joshuawe/Micromouse/README.md

# Micromouse
Micromouse TUM (Wintersemesester 2021/2022)

This is the repository of the Micromouse team of:
+ Marius
+ Michelle
+ Miriam
+ Joshua
