joshuawe/Micromouse/documents/2x2maze2.jpg

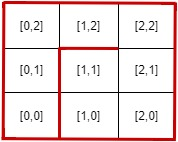
documents/2x2maze2.jpg
