joshuawe/Micromouse/documents/2x2maze.jpg

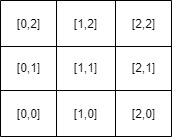
documents/2x2maze.jpg
