joshuawe/Micromouse/documents/code-structure.png

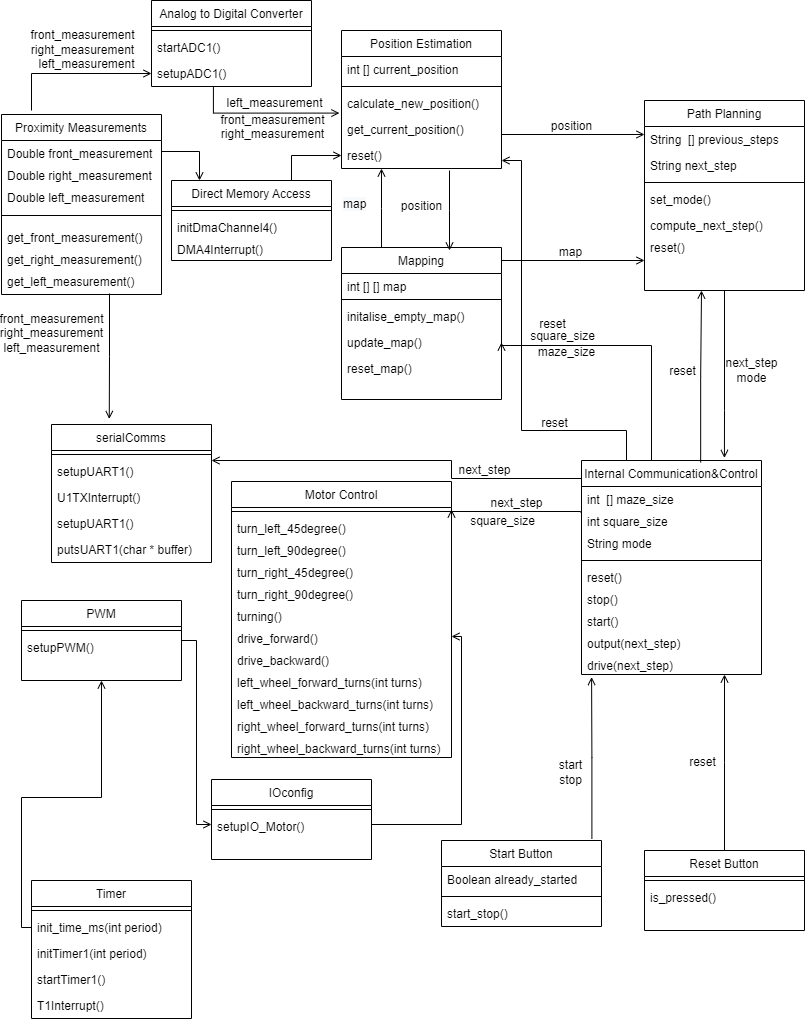
documents/code-structure.png
