joshuawe/Micromouse/documents/graphexample2.jpg

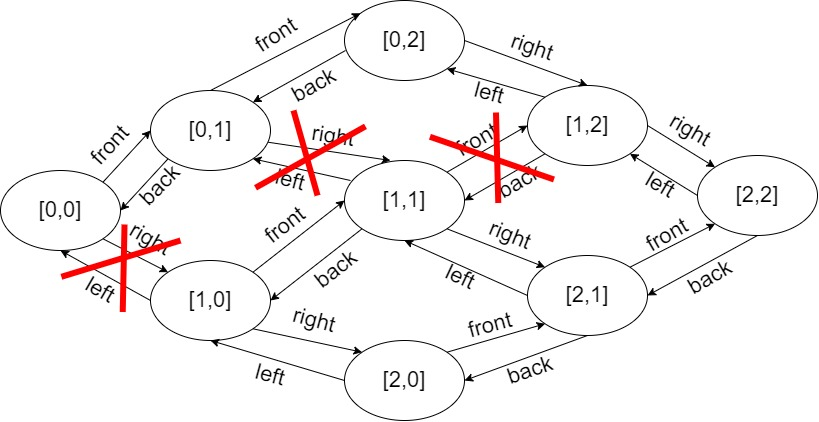
documents/graphexample2.jpg
