joshuawe/Micromouse/documents/Maze2.png

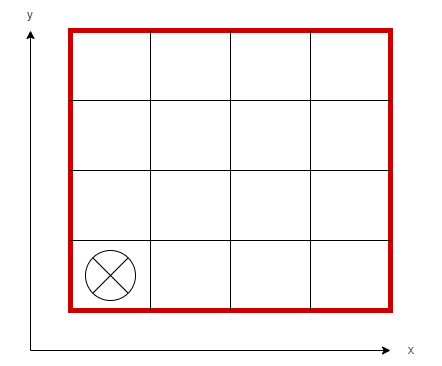
documents/Maze2.png
