joshuawe/Micromouse/documents/Maze.png

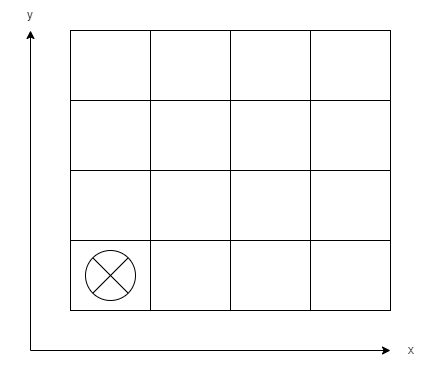
documents/Maze.png
