joshuawe/Micromouse/documents/pathplanning.png

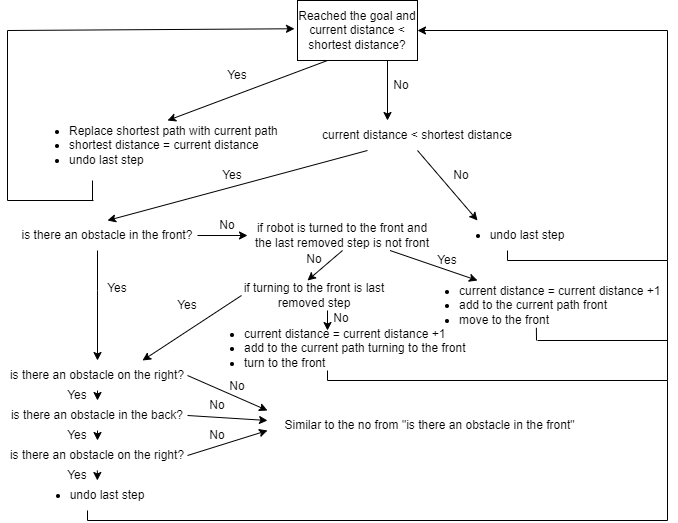
documents/pathplanning.png
