joshuawe/Micromouse/documents/speed_goal/speed-goal-graph.png

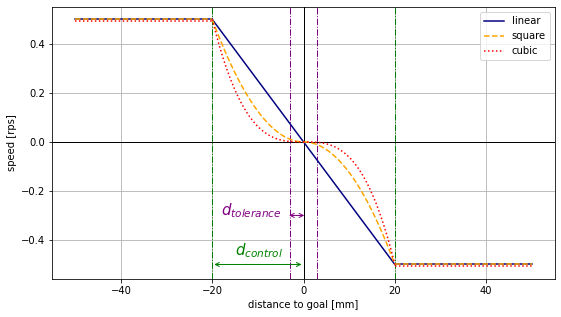
documents/speed_goal/speed-goal-graph.png
