joshuawe/Micromouse/documents/required-parts.ods

Name | Package | Value | Count | Comment
Capacitor (ceramic) | 0805 | 100nF | 9
Capacitor (ceramic) | 0805 | 15pF | 2
Capacitor (ceramic) | 0805 | 0.33uF | 2
Capacitor (tantalum) | 0805 | 4.7uF | 1
Diode | SOD123 | - | 9
Resistor | 0805 | 47kOhm | 1
Resistor | 0805 | 10kOhm | 1
Resistor | 0805 | 700Ohm | 2
Push-Button | B3F-10XX | - | 2 | 6mm x 6mm models
LED | 0805 | - | 2 | (for lights)
LED | 3MM | - | 1 | (for stabilizing the front)
L293B | DIP16 | - | 1
Crystal | HC49/S | 16kHz | 1
DSPIC33FJ64MC804 | TQFP44 | - | 1
Voltage Regulator | TO-220 | 5V | 1
Voltage Regulator | TO-220 | 3.3V | 1 | (low drop-out)
Male Headers | - | 1 x 3 Pins | 3
Male Headers | - | 1 x 6 Pins | 1 | (angled headers)
Male Headers | - | 2 x 3 Pins | 2
Female Headers | - | 1 x 4 Pins | 1
