joshuawe/Micromouse/documents/Bestellung_Micromouse_2022_01.xlsx

Sheet: RS-online
Micromouse WS 2021/22
Lieferant: RS
https://de.rs-online.com/
Name | Bestellnummer | Beschreibung | Menge | Menge mit Ersatz | Einzelpreis (ohne Mwst) | Gesamtpreis | Gesamtpreis mit Ersatz | Haben wir? | Kommentar
Proximity Sensor | 666-6568 | Sharp Reflektierender Sensor, 300mm, Herst. Teile-Nr.: GP2Y0A41SK0F | 3 | 4 | 9.72 | 29.16 | 38.88 | nein | brauchen wir nicht, wenn wir die ...51... nehmen!!
Motor | 921-1307 | Faulhaber 2619 SR Bürsten-Getriebemotor DC-Getriebemotor bis 10 Ncm 1257:1, 6 V / 1,11 W, Wellen-Ø 3mm, 26 (Dia.)mm | 2 | 2 | 203.47 | 406.94 | 406.94 | ja | nicht lieferbar, aber Alex hat wohl noch einige
Chip | 666-8491 | Digitaler Signalprozessor 16bit dsPIC33FJ64MC804-I/PT, 40MHz 16 KB 64 KB Flash, TQFP 44-Pin 9-Kanal x 10 Bit, 9-Kanal x | 1 | 2 | 5.62 | 5.62 | 11.24 | nein | nur einer lieferbar! Danach ab 25.04.22 Alex hat evtl. noch welche
Push-Button | 682-1131 | button B3f-10XX (6mm x 6mm models) | 2 | 4 | 0.596 | 1.192 | 2.384 | nein
 |  |  |  |  | Gesamtsumme: | 441.72 | 457.06
 |  |  |  |  | Summe Bestellung: | 35.972 | 52.504

Sheet: Mouser
 | Micromouse WS 2021/22
 | Lieferant: Mouser |  | Legend: | received | not received, but have it | do not have it
 | https://www.mouser.de/
ARRIVED? | Mouser-Nr | Beschreibung | Menge | Menge mit Ersatz | Einzelpreis (ohne Mwst) | Gesamtpreis | Gesamtpreis mit Ersatz | Haben wir? | Kommentar
yes | 375-BTM-01 | Bluetooth Development Tools – 802.15.1 HC-06 Bluetooth Module | 1 | 1 | 20.17 | 20.17 | 20.17 | nein
 | 749-SM0805HCL | LED low current, red, surface mount | 2 | 4 | 0.49 | 0.98 | 1.96 | nein
 | 593-LTH5MM12VFR4400 | LED 5MM | 1 | 2 | 0.971 | 0.971 | 1.942 | nein
 | 511-L293B | H-Brücke L293B | 1 | 2 | 4.77 | 4.77 | 9.54 | nein
 | 549-CY16BPS | HC49/S 16MHz Crystal | 1 | 2 | 0.578 | 0.578 | 1.156 | nein | nicht lieferbar
 | 424-6-PIN-HEADER | Male Pin Headers 1 x 6 pins | 3 | 6 | 1.3 | 3.9 | 7.8 | nein
 | 595-UA78M33CKCS | Voltage Regulator TO-220 5V | 1 | 2 | 3.17 | 3.17 | 6.34 | ja | nicht lieferbar
 | 926-LM1085IT33NOPB | Voltage Regulator TO-220 3.3 V (LDO) | 1 | 2 | 0.893 | 0.893 | 1.786 | ja
 | 71-RCG080547K0JNEA | 47 kOhm, 0805, E24 +/-5% | 1 | 2 | 0.096 | 0.096 | 0.192 | nein | E12 nicht lieferbar
 | 71-RCG080510K0JNEA | 10 kOhm, 0805, E24 +/-5% | 1 | 2 | 0.096 | 0.096 | 0.192 | nein | E12 3x so teuer
 | 71-RCG08051K00JNEA | 1 kOhm, 0805, E24 +/-5% | 2 | 4 | 0.096 | 0.192 | 0.384 | nein | E12 3x so teuer
 | 852-GP2Y0A51SK0F | Sharp distance sensor | 3 | 4 | 8.35 | 25.05 | 33.4 | ja | nicht lieferbar
 | 241-SS0520_R1_00001 | diode, surface mount, 20V, 0.5A, SOD-123 | 9 | 15 | 0.245 | 2.205 | 3.675 | nein
 | 80-C0805X104K3RAUTO | capacitor ceramic, 100nF, 0805 | 10 | 15 | 0.376 | 3.76 | 5.64 | nein
 | 80-C0805C150G8HACTU | capacitor ceramic, 15pF, 0805 | 2 | 4 | 0.175 | 0.35 | 0.7 | nein
 | 80-C0805C334J3REAULR | capacitor ceramic, 0.33uF, 0805 | 1 | 2 | 0.298 | 0.298 | 0.596 | nein
 | 963-LMR212BD7106KG-T | capacitor ceramic, 10uF, 0805 | 1 | 2 | 0.368 | 0.368 | 0.736 | nein
 | 80-T529P106M06AAE200 | capacitor tantalum, 10uF, 0805 | 1 | 2 | 1.29 | 1.29 | 2.58 | nein
 | 581-F381A475MSA | capacitor tantalum, 4.7uF, 0805 | 1 | 2 | 0.901 | 0.901 | 1.802 | nein
 |  |  |  |  | Gesamtsumme: | 70.038 | 100.591
 |  |  |  |  | Summe Bestellung: | 40.925 | 59.065
 | keine gefunden, möglich 1 x4: 437-811S100410016101 | 1 x 3 Pins, Male Headers | 3
 | keine gefunden | 2 x 3 Pins, Male Headers | 2
 | nur 1x6 gefunden(437-8018300710001101) | 1 x 4 Pins, Female Headers | 1

Sheet: Pololu
Micromouse WS 2021/22
Lieferant: Pololu
https://www.pololu.com/
Pololu-Nr | Beschreibung | Menge | Menge mit Ersatz | Einzelpreis (ohne Mwst) | Gesamtpreis | Gesamtpreis mit Ersatz | Haben wir? | Kommentar
1420 | Pololu Wheel 60×8mm Pair - Black | 2 | 2 | 4.25 | 8.5 | 8.5 | ja | Preis in USD
 |  |  |  | Gesamtsumme: | 8.5 | 8.5
 |  |  |  | Summe Bestellung: | 0 | 0

Sheet: nicht relevant
Lieferant: RS
https://de.rs-online.com/
Bestellnummer | Beschreibung | Menge | Einzelpreis | Gesamtpreis
146-0786 | Sharp Reflektierender Sensor, Oberflächenmontage, 15cm, 27 x 13.2 x 12mm | 1 | 6.63 | 6.63
666-6568 | Sharp Reflektierender Sensor, 300mm | 2 | 7.19 | 14.38
666-8444 | DSP 16bit dsPIC33FJ32MC304-I/PT, 40MHz 4 KB 32 KB Flash, TQFP 44-Pin 9-Kanal x 10 Bit, 9-Kanal x 12 Bit ADC, 1 2 | 1 | 4.29 | 4.29
636-384 | IC-Motortreiber L298N, 4A MULTIWATT V 15-Pin 4,8 → 46 V | 3 | 4.63
536-1546 | LDO-Regler LM3940IMP-3.3/NOPB, fest 1A 3,3 Vout 1 SOT-223, 3+Tab-Pin, 4,5 → 7,5 Vin | 3 | 1.37 | 4.11
795-7124 | Operationsverstärker TSV632IDT Low Power, 1,5 → 5,5 V 880kHz SOIC, 8-Pin | 10 | 0.677 | 6.77
549-356 | DSP 16bit DSPIC33FJ64MC802-I/SP, 40MIPS 16 KB 64 KB Flash, SPDIP 28-Pin 6 x 10/12 Bit ADC, 1 0 1 0 6 2 0USB | 2 | 5 | 10
 |  |  |  | 0
 |  |  | Gesamtsumme: | 46.18
 |  |  |  | 0
 |  |  |  | 0
 |  |  |  | 0
 |  |  |  | 0
 |  |  |  | 0
 |  |  |  | 0
 |  |  |  | 0
 |  |  |  | 0
 |  |  |  | 0
 |  |  |  | 0
 |  |  |  | 0
 |  |  |  | 0
 |  |  |  | 0
