joshuawe/Micromouse/documents/Heat Estimation.xlsx

Heat estimation for voltage regulator
 | Total current drawn by the devices (motors excluded because directly supplied with 9V)
 | Part | Amount | Current [mA] | Total current [mA] | Description | Link
 | LED | 3 | 30 | 90 | maximum value | LED Beispiel (https://www.reichelt.de/de/de/led-5-mm-bedrahtet-gruen-20-mcd-60--led-5mm-st-gn-p6823.html?PROVID=2788&r=1)
 | Distance Sensor | 3 | 22 | 66 | maximum value | Distance Sensor (https://global.sharp/products/device/lineup/data/pdf/datasheet/gp2y0a51sk_e.pdf)
 | H-Bridge | 2 | 60 | 120 | maximum value | H-Bridge (https://www.st.com/resource/en/datasheet/l293b.pdf)
 | Microchip VDD | 1 | 250 | 250 | maximum current into VDD (Positive supply for peripheral logic and I/O pins) | Microchip (https://ww1.microchip.com/downloads/en/DeviceDoc/70291G.pdf)
 | Bluetooth | 1 | 13 | 13 | peak value for TX and RX mode | Bluetooth (https://docs.rs-online.com/2d9d/A700000007497563.pdf)
 | Programming connector | 1 | 30 | 30 | estimated
 | Sum Total current |  |  | 569
 | With safety factor | 1.5 |  | 853.5 | e.g. for parts that are not included in the calculation
 | Voltage Regulator without Heat Sink |  |  |  | L7805CV CCD7W Vb MAR 848 TO 220 | Voltage Regulator (https://www.mouser.de/datasheet/2/389/cd00000444-1795274.pdf)
 | RthJA | 50 | [°C/W]
 | Max. allowed temp. TJmax | 125 | [°C]
 | Ambient temperature TA | 22 | [°C]
 | Max. allowed heat flow Qmax | 2.06 | [W]
 | Input Voltage Uin | 9 | [V]
 | Output Voltage Uout | 5 | [V]
 | Power loss Q = U * I | 3.414 | [W]
 | Estimated junction temp. TJ | 192.7 | [°C]
 | We need a heat sink!!!
 | Voltage Regulator with Heat Sink
 | RthJC | 5 | [°C/W]
