joshuawe/Micromouse/sensor_calibrations/Calibration_proximity_sensor.png

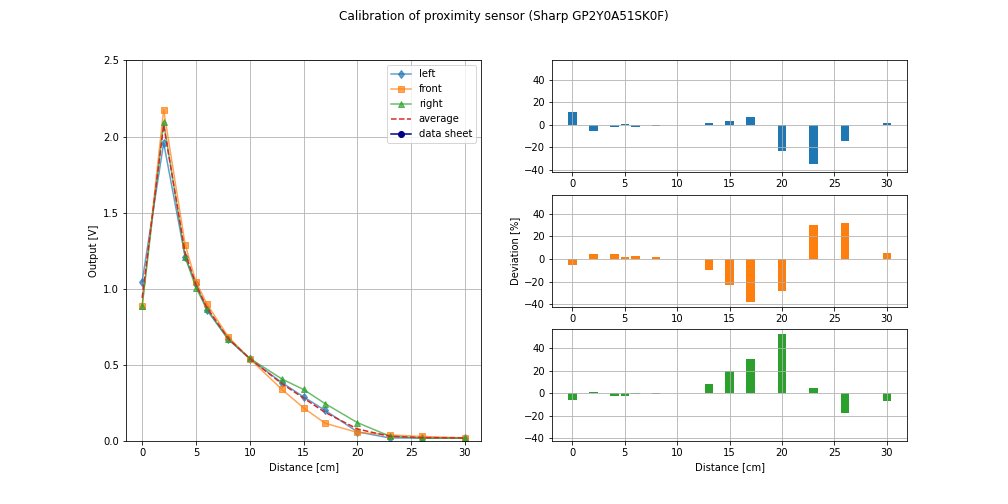
sensor_calibrations/Calibration_proximity_sensor.png
