joshuawe/Micromouse/pcb/projects/micromouse/micromouse.pdf

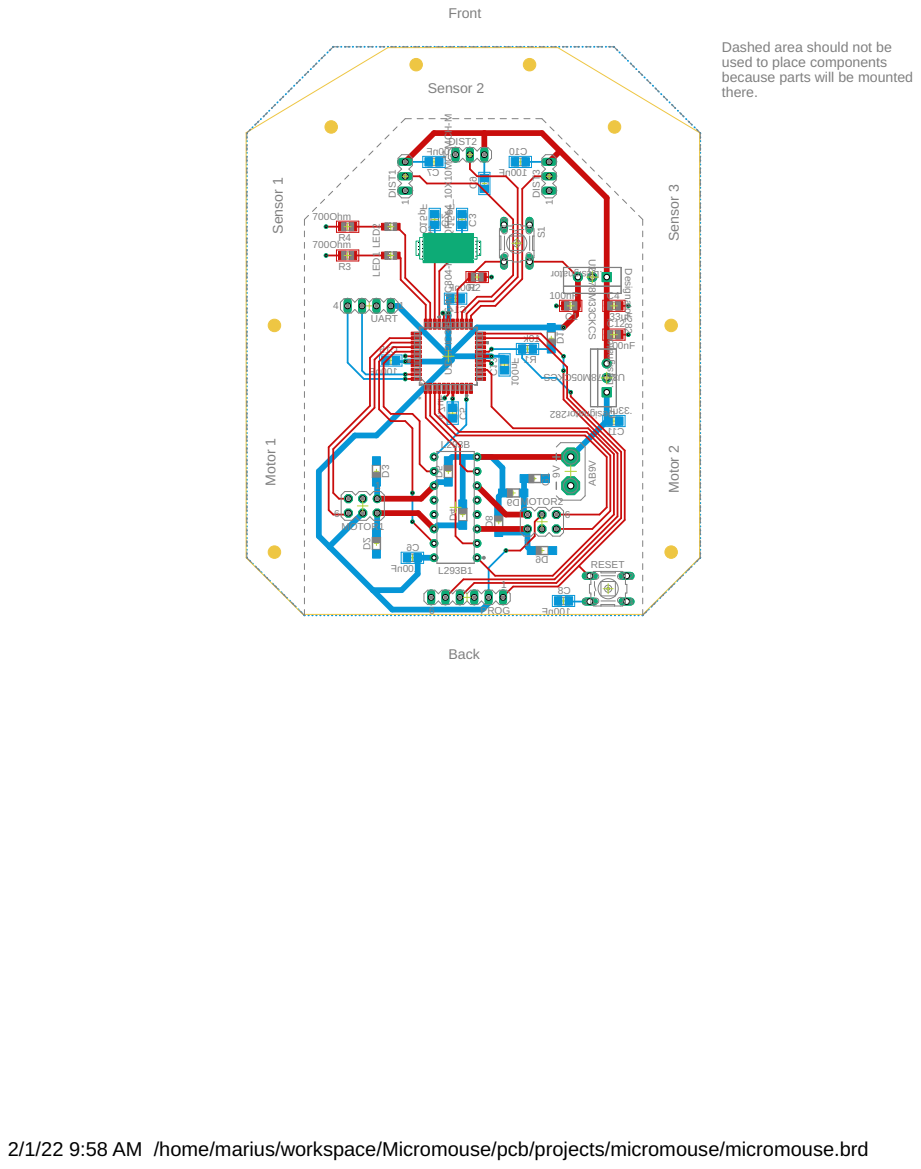
[picture p10: page 1]

Dashed area should not be
used to place components because parts will be mounted
there.

2/1/22 9:58 AM /home/marius/workspace/Micromouse/pcb/projects/micromouse/micromouse.brd
