joshuawe/Micromouse/pcb/projects/micromouse/micromouse.brd

## EAGLE design pcb/projects/micromouse/micromouse.brd (2022-02-10)

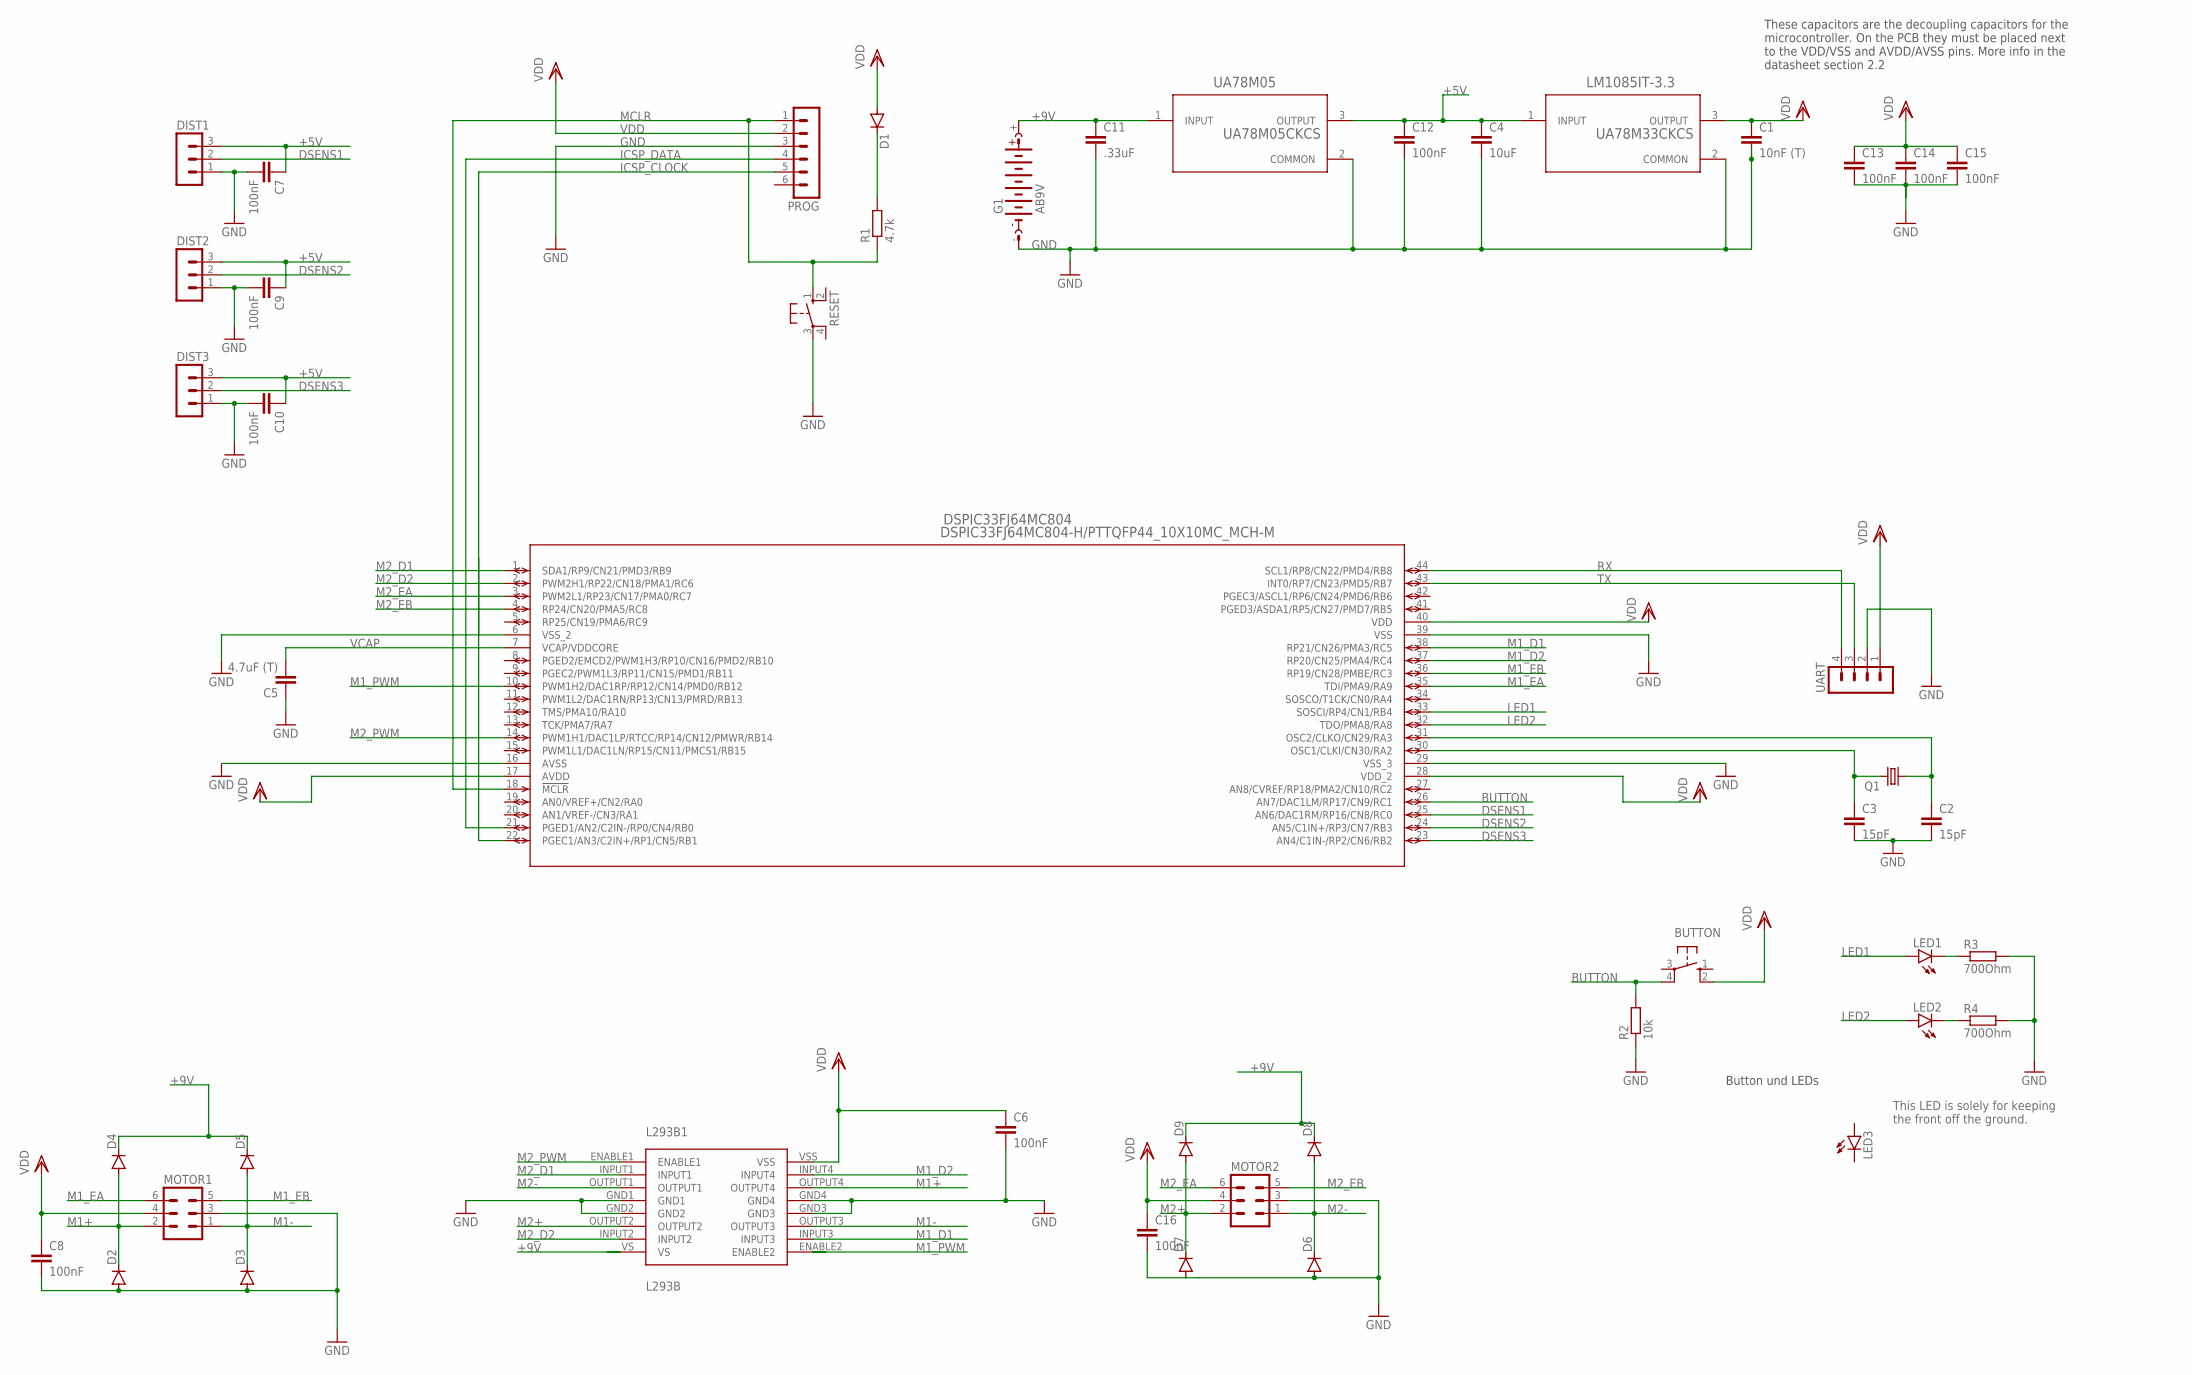
[picture p11: schematic micromouse.sch]

Parts:
BUTTON: 10-XX; B3F-10XX
C1: 10nF (T); C0805
C2, C3: 15pF; C0805
C4: 10uF; C0805
C5: 4.7uF (T); C0805
C6, C7, C8, C9, C10, C12, C13, C14, C15, C16: 100nF; C0805
C11: .33uF; C0805
D1, D2, D3, D4, D5, D6, D7, D8, D9: DIODE-SOD123; SOD123
DIST1, DIST2, DIST3: MA03-1
DSPIC33FJ64MC804: DSPIC33FJ64MC804-H/PTTQFP44_10X10MC_MCH-M; TQFP44_10X10MC_MCH-M
G1: AB9V
L293B1: L293B; L293P-DIP16
LED1, LED2: LEDCHIP-LED0805; CHIP-LED0805
LED3: LED5MM
LM1085IT-3.3: UA78M33CKCS; KCS0003B
MOTOR1, MOTOR2: MA03-2
PROG: MA06-1
Q1: CRYSTALHC49S; HC49/S
R1: 4.7k; R0805
R2: 10k; R0805
R3, R4: 700Ohm; R0805
RESET: 10-XX; B3F-10XX
UA78M05: UA78M05CKCS; KCS0003B
UART: MA04-1

Connections:
+5V: C4.1, C7.1, C9.1, C10.1, C12.1, DIST1.3, DIST2.3, DIST3.3, LM1085IT-3.3.1 (INPUT), UA78M05.3 (OUTPUT)
+9V: C11.1, D4.C, D5.C, D8.C, D9.C, G1.+, L293B1.VS, UA78M05.1 (INPUT)
BUTTON: BUTTON.4 (P1), DSPIC33FJ64MC804.26 (AN7/DAC1LM/RP17/CN9/RC1), R2.2
DSENS1: DIST1.2, DSPIC33FJ64MC804.25 (AN6/DAC1RM/RP16/CN8/RC0)
DSENS2: DIST2.2, DSPIC33FJ64MC804.24 (AN5/C1IN+/RP3/CN7/RB3)
DSENS3: DIST3.2, DSPIC33FJ64MC804.23 (AN4/C1IN-/RP2/CN6/RB2)
GND: C1.2, C2.2, C3.2, C4.2, C5.1, C6.2, C7.2, C8.2, C9.2, C10.2, C11.2, C12.2, C13.2, C14.2, C15.2, C16.2, D2.A, D3.A, D6.A, D7.A, DIST1.1, DIST2.1, DIST3.1, DSPIC33FJ64MC804.6 (VSS_2), DSPIC33FJ64MC804.16 (AVSS), DSPIC33FJ64MC804.29 (VSS_3), DSPIC33FJ64MC804.39 (VSS), G1.-, L293B1.GND1, L293B1.GND2, L293B1.GND3, L293B1.GND4, LM1085IT-3.3.2 (COMMON), MOTOR1.3, MOTOR2.3, PROG.3, R2.1, R3.2, R4.2, RESET.3, UA78M05.2 (COMMON), UART.2
ICSP_CLOCK: DSPIC33FJ64MC804.22 (PGEC1/AN3/C2IN+/RP1/CN5/RB1), PROG.5
ICSP_DATA: DSPIC33FJ64MC804.21 (PGED1/AN2/C2IN-/RP0/CN4/RB0), PROG.4
LED1: DSPIC33FJ64MC804.33 (SOSCI/RP4/CN1/RB4), LED1.A
LED2: DSPIC33FJ64MC804.32 (TDO/PMA8/RA8), LED2.A
M1+: D2.C, D4.A, L293B1.OUTPUT4, MOTOR1.2
M1-: D3.C, D5.A, L293B1.OUTPUT3, MOTOR1.1
M1_D1: DSPIC33FJ64MC804.38 (RP21/CN26/PMA3/RC5), L293B1.INPUT3
M1_D2: DSPIC33FJ64MC804.37 (RP20/CN25/PMA4/RC4), L293B1.INPUT4
M1_EA: DSPIC33FJ64MC804.35 (TDI/PMA9/RA9), MOTOR1.6
M1_EB: DSPIC33FJ64MC804.36 (RP19/CN28/PMBE/RC3), MOTOR1.5
M1_PWM: DSPIC33FJ64MC804.10 (PWM1H2/DAC1RP/RP12/CN14/PMD0/RB12), L293B1.ENABLE2
M2+: D7.C, D9.A, L293B1.OUTPUT2, MOTOR2.2
M2-: D6.C, D8.A, L293B1.OUTPUT1, MOTOR2.1
M2_D1: DSPIC33FJ64MC804.1 (SDA1/RP9/CN21/PMD3/RB9), L293B1.INPUT1
M2_D2: DSPIC33FJ64MC804.2 (PWM2H1/RP22/CN18/PMA1/RC6), L293B1.INPUT2
M2_EA: DSPIC33FJ64MC804.3 (PWM2L1/RP23/CN17/PMA0/RC7), MOTOR2.6
M2_EB: DSPIC33FJ64MC804.4 (RP24/CN20/PMA5/RC8), MOTOR2.5
M2_PWM: DSPIC33FJ64MC804.14 (PWM1H1/DAC1LP/RTCC/RP14/CN12/PMWR/RB14), L293B1.ENABLE1
MCLR: DSPIC33FJ64MC804.18 (!MCLR), PROG.1, R1.1, RESET.1 (S)
unnamed: C3.1, DSPIC33FJ64MC804.30 (OSC1/CLKI/CN30/RA2), Q1.2
unnamed: C2.1, DSPIC33FJ64MC804.31 (OSC2/CLKO/CN29/RA3), Q1.1
unnamed: D1.C, R1.2
unnamed: LED1.C, R3.1
unnamed: LED2.C, R4.1
RX: DSPIC33FJ64MC804.44 (SCL1/RP8/CN22/PMD4/RB8), UART.4
TX: DSPIC33FJ64MC804.43 (INT0/RP7/CN23/PMD5/RB7), UART.3
VCAP: C5.2, DSPIC33FJ64MC804.7 (VCAP/VDDCORE)
VDD: BUTTON.2 (S1), C1.1, C6.1, C8.1, C13.1, C14.1, C15.1, C16.1, D1.A, DSPIC33FJ64MC804.17 (AVDD), DSPIC33FJ64MC804.28 (VDD_2), DSPIC33FJ64MC804.40 (VDD), L293B1.VSS, LM1085IT-3.3.3 (OUTPUT), MOTOR1.4, MOTOR2.4, PROG.2, UART.1

Notes on the sheet:
These capacitors are the decoupling capacitors for the microcontroller. On the PCB they must be placed next to the VDD/VSS and AVDD/AVSS pins. More info in the datasheet section 2.2
Button und LEDs
This LED is solely for keeping the front off the ground.

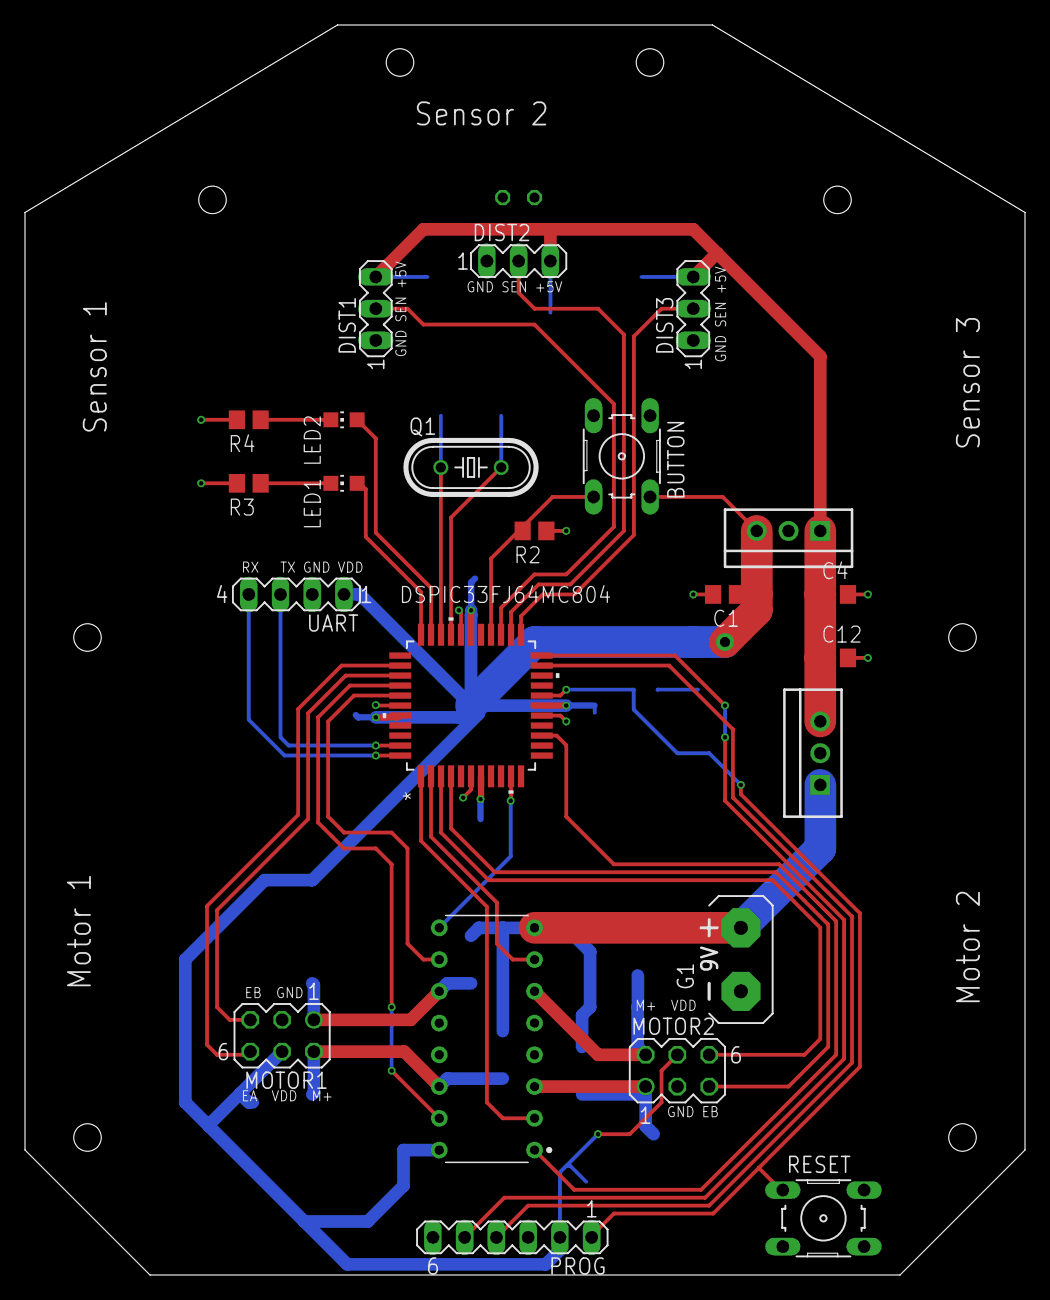
[picture p12: board micromouse.brd from above]

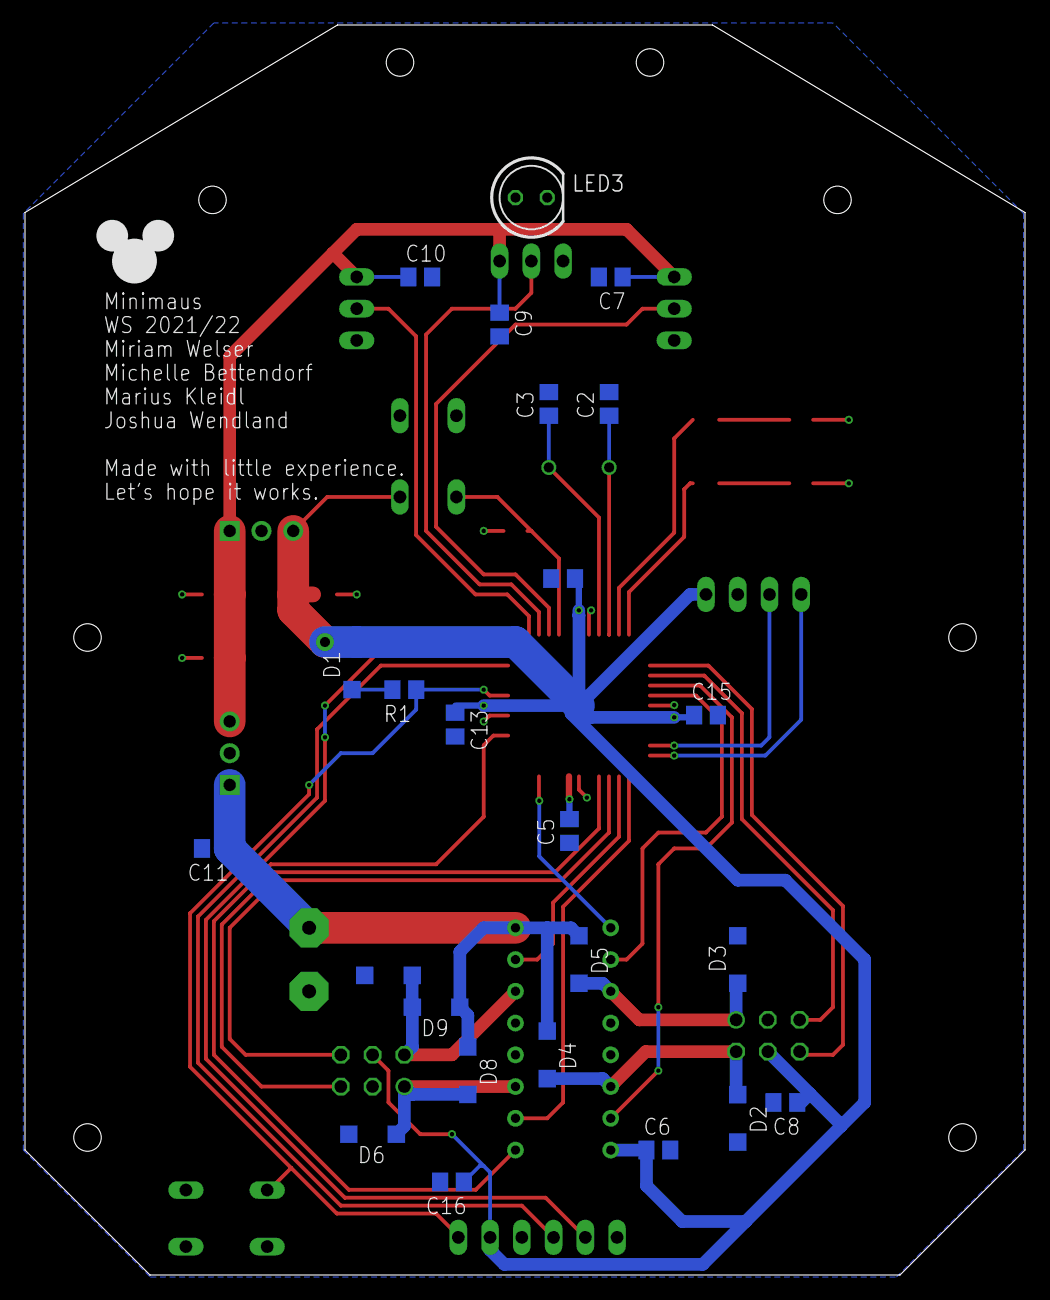
[picture p13: board micromouse.brd from below]

Board: 2 copper layers, 80.0 x 100.0 mm, 47 parts (24 on the bottom side), 35 nets.
