joshuawe/Micromouse/code/MyTestProject.X/main.c

/* 
 * File:   main.c
 * Author: Alexander Lenz
 *
 * Created on 27 Nov 2020, 09:36
 */


/// Configuration Bits---------------------------
// *** ignore this --> just the setup to run the microcontroller
// FBS
#pragma config BWRP = WRPROTECT_OFF     // Boot Segment Write Protect (Boot Segment may be written)
#pragma config BSS = NO_FLASH           // Boot Segment Program Flash Code Protection (No Boot program Flash segment)

// FGS
#pragma config GWRP = OFF               // General Code Segment Write Protect (User program memory is not write-protected)
#pragma config GSS = OFF                // General Segment Code Protection (User program memory is not code-protected)

// FOSCSEL
#pragma config FNOSC = FRC                 // Start with Internal RC Oscillator
#pragma config IESO = OFF                // Internal External Switch Over Mode (Start-up device with FRC, then automatically switch to user-selected oscillator source when ready)

// FOSC
#pragma config POSCMD = HS             // Primary Oscillator Source (HS Oscillator Mode)
#pragma config OSCIOFNC = OFF           // OSC2 Pin Function (OSC2 pin has clock out function)
#pragma config IOL1WAY = OFF            // Peripheral Pin Select Configuration (Allow Multiple Re-configurations)
#pragma config FCKSM = CSECMD           // Clock Switching and Monitor (Both Clock Switching and Fail-Safe Clock Monitor are enabled)

// FWDT
#pragma config WDTPOST = PS1            // Watchdog Timer Postscaler (1:1)
#pragma config WDTPRE = PR128           // WDT Prescaler (1:128)
#pragma config WINDIS = OFF             // Watchdog Timer Window (Watchdog Timer in Non-Window mode)
#pragma config FWDTEN = OFF             // Watchdog Timer Enable (Watchdog timer enabled/disabled by user software)

// FPOR
#pragma config FPWRT = PWR128           // POR Timer Value (128ms)
#pragma config ALTI2C = ON             // Alternate I2C  pins (I2C mapped to SDA1/SCL1 pins)
#pragma config LPOL = ON                // Motor Control PWM Low Side Polarity bit (PWM module low side output pins have active-high output polarity)
#pragma config HPOL = ON                // Motor Control PWM High Side Polarity bit (PWM module high side output pins have active-high output polarity)
#pragma config PWMPIN = ON              // Motor Control PWM Module Pin Mode bit (PWM module pins controlled by PORT register at device Reset)

// FICD
#pragma config ICS = PGD1               // Comm Channel Select (Communicate on PGC1/EMUC1 and PGD1/EMUD1)
#pragma config JTAGEN = OFF             // JTAG Port Enable (JTAG is Disabled)


/// Include headers-------------------------------
#include "xc.h"
#include "IOconfig.h"
#include "encoder.h"
#include "serialComms.h"
#include "myPWM.h"
#include "myTimers.h"
#include "adc.h"
#include "dma.h"
#include "MotorControl.h"
#include "ICC.h"
#include "mapping.h"


/// Defines----------------------------
// For our mouse, we use a 16MHz oscillator.
#define SEVEN_MEG_OSC 0 //set to 1 if we use slow (7.3728 MHz) oscillator and not 16 MHz





/*
 * 
 */
int main() 
{
    int pinStatus;
#if (SEVEN_MEG_OSC == 0)
    /*** oscillator setup --------------------------------------------------
     * The external oscillator runs at 16MHz
     * PLL is used to generate 53.3 MHz clock (FOSC)
     * The relationship between oscillator and cycle frequency: FCY = FOSC/2
     * Have a look at "PLL Configuration" paragraph in the mcu manual
    
     * Result: FCY = 0.5 * (16MHz*20/(3*2)) = 26.666 MIPS, Tcycle=37.5nsec
    ---------------------------------------------------------------------***/
    PLLFBDbits.PLLDIV = 18;           //set PPL to M=20 (18+2)
    CLKDIVbits.PLLPRE = 1;            //N1 = input/3
    CLKDIVbits.PLLPOST = 0;           //N2 = output/2
    
    
    
#else //Below the 7.3728 Setup 
    
    /*** oscillator setup --------------------------------------------------
     * The external oscillator runs at 7.3728 MHz
     * PLL is used to generate 53.3 MHz clock (FOSC)
     * The relationship between oscillator and cycle frequency: FCY = FOSC/2
     * Have a look at "PLL Configuration" paragraph in the mcu manual
    
     * Result: FCY = 0.5 * (7.3728 MHz*29/(2*2)) = 26.73 MIPS, which is 
          * not exactl Tcycle=37.5nsec, but close enough for our purposes
    ---------------------------------------------------------------------***/
    PLLFBDbits.PLLDIV = 27;           //set PPL to M=29 (27+2)
    CLKDIVbits.PLLPRE = 0;            //N1 = input/2
    CLKDIVbits.PLLPOST = 0;           //N2 = output/2
#endif //SEVEN_MEG_OSC == 0
    
    
        /* Clock switch to incorporate PLL*/
    __builtin_write_OSCCONH( 0x03 );            // Initiate Clock Switch to Primary

    // Oscillator with PLL (NOSC=0b011)
    __builtin_write_OSCCONL( OSCCON || 0x01 );  // Start clock switching
    
    while( OSCCONbits.COSC != 0b011 );
    
    // In reality, give some time to the PLL to lock
    while (OSCCONbits.LOCK != 1); //Wait for PPL to lock
 
    setupIO(); //configures inputs and outputs
    setupPWM(); 
    initQEI();
    initTimer1(delta_t_timer); //creates a x ms timer interrupt (x < 630 ms)
    
    setupUART1();
    startTimer1();
    setupADC1();
    initDmaChannel4();
    startADC1();
    
    //SRbits.IPL=3; //raise priority in order to...
    //    LED6 = LEDOFF;
    //    LED6 = LEDOFF;
    //SRbits.IPL=0; //back to normal
    
    LED1 = LEDOFF;
    LED2 = LEDOFF;
    
    setPWM(0.0, DIRECTION_FWD, 0.0, DIRECTION_FWD);
    
    initalize_map();
    /*
    map[0][0].front = 0;
    map[0][0].right = 0;
    map[0][0].back = 1;
    map[0][0].left = 1;
    
    map[0][1].front = 1;
    map[0][1].right = 1;
    map[0][1].back = 0;
    map[0][1].left = 1;

    map[0][2].front = 1;
    map[0][2].right = 0;
    map[0][2].back = 0;
    map[0][2].left = 1;

    map[1][0].front = 0;
    map[1][0].right = 0;
    map[1][0].back = 1;
    map[1][0].left = 0;

    map[1][1].front = 1;
    map[1][1].right = 0;
    map[1][1].back = 0;
    map[1][1].left = 1;

    map[1][2].front = 1;
    map[1][2].right = 0;
    map[1][2].back = 1;
    map[1][2].left = 0;

    map[2][0].front = 0;
    map[2][0].right = 1;
    map[2][0].back = 1;
    map[2][0].left = 0;

    map[2][1].front = 0;
    map[2][1].right = 1;
    map[2][1].back = 0;
    map[2][1].left = 0;

    map[2][2].front = 1;
    map[2][2].right = 1;
    map[2][2].back = 0;
    map[2][2].left = 0;
    */
   // drive_to_the_middle();
   
    
    initController();
  //  drive_forward();
    
    
    //initNewControlCycle(1,1000);
    
    //*** we do nothing forever --> wait until things are happening
    //*** --> but the interrupt function is called after xxx time
    //*** (is called by the hardware e.g. every 10 ms if this is the setup)
    while(1) 
    {
        // char* something = "hello";
        // putsUART1(something);
        
       
    };
  
    
    return 0;
}
