joshuawe/Micromouse/code/MyTestProject.X/mapping.c

/*
 * File:   mapping.c
 * Author: mibet
 *
 * Created on 25. Januar 2022, 13:36
 */


/*
 * Map starts always on the left bottom corner
 */

#include "xc.h"
#include <stdbool.h>
#include <stdio.h>
#include <stdlib.h>
#include <math.h>
#include "proxSensors.h"
#include "mapping.h"


/*typedef struct node {
    char val;
    struct node * next;
} node_t; */

int goalpositionx = 1;
int goalpositiony = 1;
int maze_size; //in cm
int square_size = 180; //in mm
int i;
char next_step;
bool visited[squares][squares]; 
bool visited_path_planning[squares][squares];
cell map[squares][squares];
char last_step;
int lastpositionx = 1;
int lastpositiony = 1;
int lasttwopositionx =1;
int lasttwopositiony =1;
node_t * shortestpath = NULL;
node_t * currentpath = NULL;
int currentdistance = 0;
int mindistance = 16; // maximal cell number, so that there isn't an endless loop


void set_maze_size(int size)
{
    maze_size = size;
}

void set_square_size(int square)
{
    square_size = square;
}

/*
 * position is set in the size of the maze (e.g. (0,0) is start (0,1) is one step forward)
 */
/*void set_position(int positionx, int positiony)
{
    position[0] = positionx/square_size;
    position[1] = positiony/square_size;
}*/

char get_next_step()
{
    return next_step;
}

int get_next_step_int()
{
    if(next_step == 'f')
    {
        return 0;
    }
    else if(next_step == 'r')
    {
        return 1;
    }
    else if(next_step == 'b')
    {
        return 2;
    }
    else if(next_step == 'l')
    {
        return 3;
    }
    else if(next_step == 't')
    {
        return 4;
    }
    return -1;
    
}
void set_goal_position(int new_goalpositionx, int new_goalpositiony)
{
    goalpositionx = new_goalpositionx;
    goalpositiony = new_goalpositiony;
}

/*
 * free = 0, obstacle  = 1, unsure = -1
 * binary: bottom, left, up, right
 * connections numbers start from left bottom with 0,1,2,3 then going one square up: 
 */
void initalize_map()
{
    int o, j;
    for(o = 0; o < squares; o++)
    {
        for(j=0; j < squares; j++)
        {
            map[o][j].back = -1;
            map[o][j].left = -1;
            map[o][j].right = -1;
            map[o][j].front = -1;
            visited[o][j] = false;
            visited_path_planning[o][j] = false;
            
        }
    }        
    visited[0][0] = true;
    
   // squares = (int)maze_size/square_size;
    /*
    for (i = 0; i < squares; i++)
    {
        map[0][i].left = 1;
        map[i][0].back = 1;
        map[squares][i].right = 1;
        map[i][squares].front = 1;
    */
    
}

/*
 * add from the new measurements walls in the map
 */
void update_map(int positionx, int positiony, int orientation)
{
    if (orientation == 0)
    {
        map[positionx][positiony].front = distanceFront < 100;
        map[positionx][positiony].left = distanceLeft < 100;
        map[positionx][positiony].right = distanceRight < 100;
    }
    else  if (orientation == 1) //turned right
    {
            map[positionx][positiony].right = distanceFront < 100;
            map[positionx][positiony].front = distanceLeft < 100;   
            map[positionx][positiony].back = distanceRight < 100;
           
    }
    else if (orientation == 2) // turned back
    {
            map[positionx][positiony].back = distanceFront <100;
            map[positionx][positiony].right = distanceLeft < 100;
            map[positionx][positiony].left = distanceRight < 100;
    }
    else if (orientation == 3 ) //turned left
    {
            map[positionx][positiony].left = distanceFront < 100;
            map[positionx][positiony].back = distanceLeft < 100;
            map[positionx][positiony].front = distanceRight < 100;
    }
}

/* explore left part of the map
 */
int exploreleft(int positionx, int positiony, int orientation)
{
    if(positionx == 0 || map[positionx][positiony].left == 1) // if the robot is on the very left of the maze or there is a wall on the left
    {
        return -1;
    }    
    else if(visited[positionx-1][positiony] == true) //left square was already visited
    {
        return -1;
    }
    
    if(orientation == 0)
    {
        next_step = 'l';
        
    }
    else if(orientation == 1)
    {
        next_step = 't';
    }
    else if(orientation == 2)
    {
        next_step = 'r'; 
    }
    else
    {
        next_step = 'f';
        visited[positionx-1][positiony] = true;
    }
    return 1;
}

/* explore front part of the map
 */
int explorefront(int positionx, int positiony, int orientation)
{
    if(positiony >= squares - 1 || map[positionx][positiony].front == 1) // if the robot is on the very top of the maze or there is a wall on the left
    {
        return -1;
    }    
    else if(visited[positionx][positiony+1] == true) //left square was already visited
    {
        return -1;
    }
    
    if(orientation == 0)
    {
        next_step = 'f';
        visited[positionx][positiony+1] = true;
        
    }
    else if(orientation == 1)
    {
        next_step = 'l';
    }
    else if(orientation == 2)
    {
        next_step = 't'; 
    }
    else
    {
        next_step = 'r';
    }
    
    return 1;
}
int exploreback(int positionx, int positiony, int orientation)
{
    if( map[positionx][positiony].back == 1) // if the robot is on the very top of the maze or there is a wall on the left
        
    {
        return -1;
    }    
    else if(visited[positionx][positiony-1] == true) //left square was already visited
    {
        return -1;
    }
    
    if(orientation == 0)
    {
        next_step = 't';
            
    }
    else if(orientation == 1)
    {
        next_step = 'r';
    }
    else if(orientation == 2)
    {
        next_step = 'f'; 
        visited[positionx][positiony-1] = true;
    }
    else
    {
        next_step = 'l';
    }
   
    
    return 1;
}

/* explore right part of the map
 */
int exploreright(int positionx, int positiony, int orientation)
{
    if(positionx == squares -1 || map[positionx][positiony].right == 1) // if the robot is on the very left of the maze or there is a wall on the left
    {
        return -1;
    }    
    else if(visited[positionx+1][positiony] == true) //left square was already visited
    {
        return -1;
    }
    
    if(orientation == 0)
    {
        next_step = 'r';
    }
    else if(orientation == 1)
    {
        next_step = 'f';
        visited[positionx+1][positiony] = true;
    }
    else if(orientation == 2)
    {
        next_step = 'l';
    }
    else
    {
        next_step = 't';
    }
    
    return 1;
}

int deadend(int positionx, int positiony, int orientation)
{
    if(orientation == 0)
    {
        if(map[positionx][positiony].front == 1 && map[positionx][positiony].left == 1 && map[positionx][positiony].right == 1)
        {
            next_step = 't';
            visited[positionx][positiony-1] = false;
            return 1;
        }
    }
    else if (orientation == 1)
    {
        if(map[positionx][positiony].front == 1 && map[positionx][positiony].back == 1 && map[positionx][positiony].right == 1)
        {
            next_step = 't';
            visited[positionx-1][positiony] = false;
            return 1;
        }
    }
    else if (orientation == 2)
    {
      if(map[positionx][positiony].back == 1 && map[positionx][positiony].left == 1 && map[positionx][positiony].right == 1)
        {
            next_step = 't';
            visited[positionx][positiony+1] = false;
            return 1;
        }
    }
    else
    { 
        if(map[positionx][positiony].front == 1 && map[positionx][positiony].left == 1 && map[positionx][positiony].back == 1)
        {
            next_step = 't';
            visited[positionx+1][positiony] = false;
            return 1;
        }
    }
    return -1;
}

/* check if every square of the map is explored
 */
int allexplored()
{
    int k,l;
    for(k = 0; k < squares; k++)
    {
        for(l = 0; l < squares; l++)
        {
            if(visited[k][l] == false)
            {
                return -1;
            }
        }
    }
    return 1;
}

/* list functions from https://www.learn-c.org/de/Linked%20lists
 * remove the last element from a list
*/
char remove_last(node_t * head) {
    /* if there is only one element */
    char last;
    
    node_t * current = head;

    if (head->next == NULL) {
        last = head->val;
        free(head);
        head = NULL;
        return 'x';
    }

    while (current->next->next != NULL) {
        current = current->next;
    }
    last = current->next->val;
    current->next = NULL;
    return last;
}

/* remove the first element of a list */
int pop(node_t ** head) {
    
    node_t * next_node = NULL;

    if (*head == NULL) {
        return -1;
    }

    next_node = (*head)->next;
    free(*head);
    *head = next_node;

    return 1;
}

/* add a value to list
 */
void push(node_t * head, char val) {
    node_t * current = head;
    while (current->next != NULL) {
        current = current->next;
    }

    /* jetzt koennen wir eine neue Variable hinzufuegen */
    current->next = malloc(sizeof(node_t));
    current->next->val = val;
    current->next->next = NULL;
    if (last_step != 'x')
    {
        last_step = 'u'; //unknown last step as there is now a new path
    }
}

/*replace the values of one list to the other
 */
void replace_list(node_t * old, node_t * current) {

    //old = old->next;
    //old = old->next;
    while(remove_last(old)!= 'x')
    {
    }
    //current = current->next;
    while (current != NULL) {
        push(old,current->val);
        current = current->next;
        
    }
    //if current is shorter than old, remove the rest of the old list
   /* while (old->next->next != NULL) {
        old = old->next;
    }*/
}

int undo_last_step(int positionx, int positiony, int orientation)
{
    last_step = remove_last(currentpath);
    if(last_step == 'x')
    {  return -1; }
    else{
    currentdistance--;
    if(orientation == 0)
            {
                if(last_step == 'f')
                {
                    visited_path_planning[lasttwopositionx][lasttwopositiony] = false;
                    lasttwopositionx = lastpositionx;
                    lasttwopositiony = lasttwopositiony;
                    lastpositionx = positionx;
                    lastpositiony = positiony;
                    calculatepath(positionx, positiony-1, 0);
                }
                else if(last_step == 'b')
                { 
                    visited_path_planning[lasttwopositionx][lasttwopositiony] = false;
                    lasttwopositionx = lastpositionx;
                    lasttwopositiony = lasttwopositiony;
                    lastpositionx = positionx;
                    lastpositiony = positiony;
                    calculatepath(positionx, positiony+1,0);
                    
                }
                else if(last_step == 'l')
                {
                    calculatepath(positionx, positiony, 1);
                }
                else if(last_step == 'r')
                {
                    calculatepath(positionx, positiony, 3);
                }
                else
                { /* ERROR*/ }
            }
            else if(orientation == 1)
            {
                if(last_step == 'f')
                {
                    visited_path_planning[lasttwopositionx][lasttwopositiony] = false;
                    lasttwopositionx = lastpositionx;
                    lasttwopositiony = lasttwopositiony;
                    lastpositionx = positionx;
                    lastpositiony = positiony;
                    calculatepath(positionx-1, positiony, 1);
                }
                else if(last_step == 'b')
                {
                    visited_path_planning[lasttwopositionx][lasttwopositiony] = false;
                    lasttwopositionx = lastpositionx;
                    lasttwopositiony = lasttwopositiony;
                    lastpositionx = positionx;
                    lastpositiony = positiony;
                    calculatepath(positionx+1, positiony,1);
                }
                else if(last_step == 'l')
                {
                    calculatepath(positionx, positiony, 2);
                }
                else if(last_step == 'r')
                {
                    calculatepath(positionx, positiony, 0);
                }
                else
                { /* ERROR*/ }

            }
            else if(orientation == 2)
            {
                if(last_step == 'f')
                {
                    visited_path_planning[lasttwopositionx][lasttwopositiony] = false;
                    lasttwopositionx = lastpositionx;
                    lasttwopositiony = lasttwopositiony;
                    lastpositionx = positionx;
                    lastpositiony = positiony;
                    calculatepath(positionx, positiony+1, 2);
                }
                else if(last_step == 'b')
                {
                    visited_path_planning[lasttwopositionx][lasttwopositiony] = false;
                    lasttwopositionx = lastpositionx;
                    lasttwopositiony = lasttwopositiony;
                    lastpositionx = positionx;
                    lastpositiony = positiony;
                    calculatepath(positionx, positiony-1,2);
                }
                else if(last_step == 'l')
                {
                    calculatepath(positionx, positiony, 3);
                }
                else if(last_step == 'r')
                {
                    calculatepath(positionx, positiony, 1);
                }
                else
                { /* ERROR*/ }

            }
            else if(orientation == 3)
            {
                if(last_step == 'f')
                {
                    visited_path_planning[lasttwopositionx][lasttwopositiony] = false;
                    lasttwopositionx = lastpositionx;
                    lasttwopositiony = lasttwopositiony;
                    lastpositionx = positionx;
                    lastpositiony = positiony;
                    calculatepath(positionx+1, positiony, 3);

                }
                else if(last_step == 'b')
                {
                    visited_path_planning[lasttwopositionx][lasttwopositiony] = false;
                    lasttwopositionx = lastpositionx;
                    lasttwopositiony = lasttwopositiony;
                    lastpositionx = positionx;
                    lastpositiony = positiony;
                    calculatepath(positionx-1, positiony,3);
                }
                else if(last_step == 'l')
                {
                    calculatepath(positionx, positiony, 0);
                }
                else if(last_step == 'r')
                {
                    calculatepath(positionx, positiony, 2);
                }
                else
                { /* ERROR*/ }

            }
    }
    return 1;
    
}
/* recursive method to find the shortest path 
 */
int calculatepath(int positionx, int positiony, int orientation)
{
    if (last_step == 'x')
        {
            return -1;
        }
    if(positionx == goalpositionx && positiony == goalpositiony && currentdistance < mindistance)
    {
        printf("goalposition found\n\r");
        replace_list(shortestpath, currentpath); //currentpath will get the shortestpath
        mindistance = currentdistance;
        if(undo_last_step(positionx, positiony, orientation)== -1)
        {
            return -1;
        }
        visited_path_planning[goalpositionx][goalpositiony] = false;
    }
    else
    {     
        printf("calculating\n\r");
        if(currentdistance < mindistance)
        {
            if(map[positionx][positiony].front != 1 && !visited_path_planning[positionx][positiony+1])
            {
                if(orientation == 0 && last_step != 'f')
                {
                    currentdistance++;
                    push(currentpath, 'f');
                    visited_path_planning[positionx][positiony+1] = true;
                    calculatepath(positionx, positiony + 1, 0);
                }
                else if (orientation == 1 && last_step != 'l')
                {
                    currentdistance++;
                    push(currentpath, 'l'); // turning to the front
                    calculatepath(positionx, positiony, 0);
                }
                else if (orientation == 2 && last_step != 'l')
                {
                    currentdistance++;
                    push(currentpath, 'l'); //moving backward
                    //visited_path_planning[positionx][positiony+1] = true;
                    calculatepath(positionx, positiony, 1);
                }
                else if (orientation == 3 && last_step != 'r')
                {
                    currentdistance++;
                    push(currentpath, 'r'); // turning to the front
                    calculatepath(positionx, positiony, 0);
                }
                else 
                {
                    printf("else1 \n\r");
                    //undo_last_step(positionx,positiony, orientation);
                }
                
            }
            if(map[positionx][positiony].right != 1 && !visited_path_planning[positionx+1][positiony])
            {
                if(orientation == 0 && last_step != 'r')
                {
                    currentdistance++;
                    push(currentpath, 'r');
                    calculatepath(positionx, positiony, 1);
                }
                else if (orientation == 1 && last_step != 'f')
                {
                    currentdistance++;
                    push(currentpath, 'f') ;
                    visited_path_planning[positionx+1][positiony] = true;
                    calculatepath(positionx+1, positiony, 1);
                }
                else if (orientation == 2 && last_step != 'l')
                {
                    currentdistance++;
                    push(currentpath, 'l');
                    calculatepath(positionx, positiony, 1);
                }
                else if (orientation == 3 && last_step != 'l')
                {
                    currentdistance++;
                    push(currentpath, 'l');
//                    visited_path_planning[positionx+1][positiony] = true;
                    calculatepath(positionx, positiony, 2);
                }
                else
                {
                    printf("else2 \n\r");
                    //undo_last_step(positionx,positiony, orientation);
                }
            }
            if(map[positionx][positiony].back != 1 && !visited_path_planning[positionx][positiony-1])
            {
                if(orientation == 0 && last_step != 'l')
                {
                    currentdistance++;
                    push(currentpath, 'l');
                    //visited_path_planning[positionx][positiony-1] = true;
                    calculatepath(positionx, positiony, 3);
                }
                else if (orientation == 1 && last_step != 'r')
                {
                    currentdistance++;
                    push(currentpath, 'r');
                    calculatepath(positionx, positiony, 2);
                }
                else if (orientation == 2 && last_step != 'f')
                {
                    currentdistance++;
                    push(currentpath, 'f');
                    visited_path_planning[positionx][positiony-1] = true;
                    calculatepath(positionx, positiony-1, 2);
                }
                else if (orientation == 3 && last_step != 'l')
                {
                    currentdistance++;
                    push(currentpath, 'l');
                    calculatepath(positionx, positiony, 2);
                }
                else 
                {
//                    printf("else3 \n\r");
                   // undo_last_step(positionx,positiony, orientation);
                }
            }
            /*
            printf("positionx %d \n\r", positionx);
            printf("positiony %d \n\r", positiony);
            printf("orientation %d \n\r", orientation);
            printf("visited_path_planning[positionx-1][positiony] %d \n\r", visited_path_planning[positionx-1][positiony]);
            printf("map[positionx][positiony].left %d \n\r", map[positionx][positiony].left);*/
            
            if(map[positionx][positiony].left != 1  && !visited_path_planning[positionx-1][positiony] )
            {
//                printf("last_step: %c\n", last_step);
               if(orientation == 0 && last_step != 'l')
                {
                    currentdistance++;
                    push(currentpath, 'l');
                    calculatepath(positionx, positiony, 3);
                }
               else if (orientation == 1 && last_step != 'l')
                {
                    currentdistance++;
                    push(currentpath, 'l') ;
                    //visited_path_planning[positionx-1][positiony] = true;
                    calculatepath(positionx, positiony, 0);
                }
               else if (orientation == 2 && last_step != 'r')
                {
                    currentdistance++;
                    push(currentpath, 'r');
                    calculatepath(positionx, positiony, 3);
                }
               else if (orientation == 3 && last_step != 'f')
                {
                    currentdistance++;
                    push(currentpath, 'f');
                    visited_path_planning[positionx-1][positiony] = true;
                    calculatepath(positionx-1, positiony, 3);
                }
               else
               {
                   printf("else4 \n\r");
                   //undo_last_step(positionx,positiony, orientation);
               }
            }
            // either walls or already visited cells around the current cell
                       
            if(undo_last_step(positionx, positiony, orientation)== -1)
            {
                
                printf("only walls or already visited cells \n\r");
                return -1;
            }
        }
        else // not possible to reach the goal with less steps than already -> remove last element
        {
            if(undo_last_step(positionx, positiony, orientation)== -1)
            {
              printf("currentdistance > mindistance \n\r");
              return -1;
            }         
        }
    }
    return 1;
}

/* calculates the shortest path from the start position to the goalposition
 */
node_t * calculateshortestpath(int positionx, int positiony, int orientation)
{
    int o, j;
    for(o = 0; o < squares; o++)
    {
        for(j=0; j < squares; j++)
        {
            visited_path_planning[o][j] = false;
            printf("map[%d][%d].front = %d;\r\n", o, j, map[o][j].front);
            printf("map[%d][%d].right = %d;\r\n", o, j, map[o][j].right);
            printf("map[%d][%d].back = %d;\r\n", o, j, map[o][j].back);
            printf("map[%d][%d].left = %d;\r\n", o, j, map[o][j].left);

            
        }
    }
    mindistance = 16;
    currentdistance = 0;
    last_step = 'u';
    shortestpath = calloc(sizeof(node_t), 1);
    currentpath = calloc(sizeof(node_t), 1);
    pop(currentpath);
    visited_path_planning[positionx][positiony] = true;
    calculatepath(positionx, positiony, orientation);
    //shortestpath = shortestpath->next;
    return shortestpath;
}

int drive_shortest_path()
{
    
    //currentpath = currentpath->next;
    shortestpath = shortestpath->next;
    next_step = shortestpath->val;
    printf("shortestpath %c\n\r", next_step);
    //check if the last element is removed
    if(pop(shortestpath) == -1)
    { 
        printf("no element in shortest path\r\n");
        return -1;
    }
    
    return 1;
}

void find_unvisited(int * x, int * y)
{
    int k,l;
    for(k = 0; k < squares; k++)
    {
        for(l = 0; l < squares; l++)
        {
            if(visited[k][l] == false)
            {
                * x = k;
                * y = l;
            }
        }
    }
}

void move(int positionx, int positiony, int orientation)
{
    int k,l;
    for(k = 0; k < squares; k++)
    {
        for(l = 0; l < squares; l++)
        {
            if(visited[k][l] == false)
            {
                set_goal_position(k,l);
                printf("goalposition %d %d\n\r", k, l);
                calculateshortestpath(positionx, positiony, orientation);
                drive_shortest_path();    
                return;
            }
        }
    }
}

/* explore the whole maze
 */
void explore(int positionx, int positiony, int orientation)
{
    printf("explore \n\r");
    if(explorefront(positionx, positiony, orientation)== -1)
    {
        if(exploreleft(positionx,  positiony, orientation) == -1)
        {
            if(exploreright( positionx,  positiony, orientation) == -1)
            {
                if(exploreback( positionx,  positiony, orientation) == -1)
                {
                    if(allexplored() == -1)
                    {
                        if(deadend(positionx, positiony, orientation) == -1)
                        {
                            move(positionx,  positiony, orientation);
                        }
                        
                    }
                }
            }
        }
    }
}

node_t * get_shortestpath()
{
    return shortestpath;
}

node_t * get_currentpath()
{
    return currentpath;
}
