joshuawe/Micromouse/code/MyTestProject.X/adc.h

/* 
 * File:   adc.h
 * Author: a2-lenz
 *
 * Created on December 10, 2018, 4:59 PM
 */

#ifndef ADC_H
#define	ADC_H






/*! \brief configures the 12bit analog-to-digital converter (ADC1).
 * 
 */
void setupADC1(void);
void startADC1(void);










#endif	/* ADC_H */
