joshuawe/Micromouse/(commit log)

2022-01-11 bestellungen unfertig
    [Bestellung_RS_2022_01.xls]
2022-01-12 Updated the Bestellliste
    [Bestellung_Micromouse_2022_01.xlsx, Bestellung_RS_2022_01.xls]
2022-01-12 updated BEstellliste
    [Bestellung_Micromouse_2022_01.xlsx]
2022-01-14 with comments from meeting with Alex
    [Heat Estimation.xlsx]
2022-01-18 Add PCB
    [micromouse.brd, micromouse.sch]
2022-01-18 Add value for resistors for LEDs
    [micromouse.brd, micromouse.sch]
2022-01-20 Add solder pad for distance sensor and battery
    [micromouse.brd, micromouse.sch]
2022-01-21 Use TO-220 for voltage reguators
    [micromouse.brd, micromouse.sch]
2022-01-21 Recreate board layout
    [micromouse.brd]
2022-01-21 Position components
    [micromouse.brd, micromouse.sch]
2022-01-21 Most wiring done
    [micromouse.brd, micromouse.sch]
2022-01-21 Complete wiring
    [micromouse.brd, micromouse.sch]
2022-01-21 Ground plane and ground connections
    [micromouse.brd]
2022-01-25 Bestellliste aktualisiert + MotorControl.c
    [Bestellung_Micromouse_2022_01.xlsx]
2022-01-25 Replace LED with 0805 package
    [micromouse.brd, micromouse.sch]
2022-01-25 Make motor and encoder work
2022-01-25 Import design rules
    [micromouse.brd]
2022-01-25 Remove restricted areas for microship
    [micromouse.brd, micromouse.sch]
2022-01-25 Fix overlapping errors
    [micromouse.brd]
2022-01-29 Import new board shape
    [micromouse.brd]
2022-01-30 Replace some pin connectors
    [micromouse.brd, micromouse.sch]
2022-01-31 Routing for new PCB
    [micromouse.brd, micromouse.sch]
2022-02-01 Update reset button
    [micromouse.brd, micromouse.sch]
2022-02-07 LED and resistor value
    [micromouse.brd, micromouse.sch]
2022-02-07 Required parts
    [required-parts.ods]
2022-02-08 Bestellliste aktualisiert
    [Bestellung_Micromouse_2022_01.xlsx]
2022-02-09 neuer Widerstand
    [Bestellung_Micromouse_2022_01.xlsx]
2022-02-10 Final PCB touches
    [micromouse.brd, micromouse.sch]
2022-02-11 code structure + bestellliste updated
    [Bestellung_Micromouse_2022_01.xlsx]
2022-02-16 Update Bestellliste
    - Widerstände
    - Diode
    - Sensoren
    - Räder
    [Bestellung_Micromouse_2022_01.xlsx]
2022-02-17 Updated voltage regulator and crystal
    [Bestellung_Micromouse_2022_01.xlsx]
2022-03-15 Updated received parts
    [Bestellung_Micromouse_2022_01.xlsx]
2022-03-16 Correct device
2022-03-18 Fix compile errors in mapping.c
    [mapping.c]
2022-03-18 Enable LEDs
2022-03-18 Active timer
2022-03-18 Activate button
2022-03-18 fixup! Active timer
2022-03-18 fixup! fixup! Active timer
2022-03-18 Clear up UART configuration
2022-03-18 Bestelliste mit Farbencodierung
    [Bestellung_Micromouse_2022_01.xlsx]
2022-03-18 Setup code for motor PWM
2022-03-21 UART working now with Baudrate 9600
2022-03-21 Fix pins for UART
    [IOconfig.c]
2022-03-21 Proximity sensors define motor speed
2022-03-23 Make one encoder work
2022-03-24 Make second encoder work
2022-03-24 Read values from distance sensors /proximity sensors
2022-03-24 sensor calibrations
    [measurements.csv]
2022-03-24 motor speed function easy
2022-03-24 Print proximity sensor values
2022-03-24 Fix garbage at the begining of bluetooth transmission
    [proxSensors.h, serialComms.c]
2022-03-29 new files controller.c and .h
    ✨controller.c and .h
2022-03-29 🎨 change of struct declarations
    🎨 change of struct declarations
2022-03-29 🎨 edit MotorControl
    [micromouse.sch]
2022-03-30 Some compiler fixes in MotorControl.h
    [MotorControl.c]
2022-03-30 Add UART parser
2022-03-31 updated interrupts
2022-03-31 Make encoder work correctly
    [encoder.c, myTimers.c]
2022-03-31 ✨ added PID controller (not finished)
    ✨ header motor control and functions in *.c updated
2022-04-01 updated the new encoder function
2022-04-02 ✨ almost finished PID controller and changed WHEEL RADIUS in encoder.c
2022-04-02 ✨ added calculation of turning speed in rounds / s
2022-04-02 🎨 changed names of new variables
2022-04-02 🎨 edit of controller and minor changes in other files
    - definition of constants
    - change of error for velocity control
    - optional feedforward term
    - comments and descriptions of functions
    - init control cycle
    - update header
    [MotorControl.c, MotorControl.h, encoder.c, main.c, mapping.h]
2022-04-02 ✨ stops when a wall is in front to avoid collision
    [MotorControl.c, MotorControl.h]
2022-04-03 ✨ calibration implemented and output for debugging
2022-04-04 Updated Mouse measurements for currrent (old) CAD version, which we will use until the new 3D printed parts arrive
2022-04-04 Rework controller and measurements
    [MotorControl.c, MotorControl.h, encoder.c, encoder.h, main.c, myTimers.c, proxSensors.c, proxSensors.h]
2022-04-04 Fixed speed calculation issues
    [encoder.c, encoder.h, myTimers.c]
2022-04-05 Remove unused print functions
2022-04-05 Fixed logic in function checkOutputIfItExceedsMaximum
    [MotorControl.c]
2022-04-05 With velocity control depending on distance
2022-04-06 Refactor error from proximity sensors
    [MotorControl.c, myTimers.c]
2022-04-06 better Controller, adjusted cell size, added front calibration
2022-04-06 corrected P_D differential value
    [MotorControl.c]
2022-04-13 Add comment about problem
    [MotorControl.c]
2022-04-25 Corrected prox sensor plot
2022-04-29 adjusted binary search for Motor PWM
