joshuawe/Micromouse/(notices)

Notices in the files:
parts and their libraries:
micromouse: COPYRIGHT: Copyright (C) 2022 Ultra Librarian. All rights reserved.
